jh-yip/Survivor/cores/managed_ip_project/managed_ip_project.runs/clk_wiz_various_synth_1/.vivado.begin.rst

<?xml version="1.0"?>
<ProcessHandle Version="1" Minor="0">
    <Process Command="vivado.bat" Owner="kzhan" Host="KJANRAY" Pid="13800" HostCore="8" HostMemory="016873873408">
    </Process>
</ProcessHandle>
